ekaggrat/eptaora/stl/main drive gear.stl

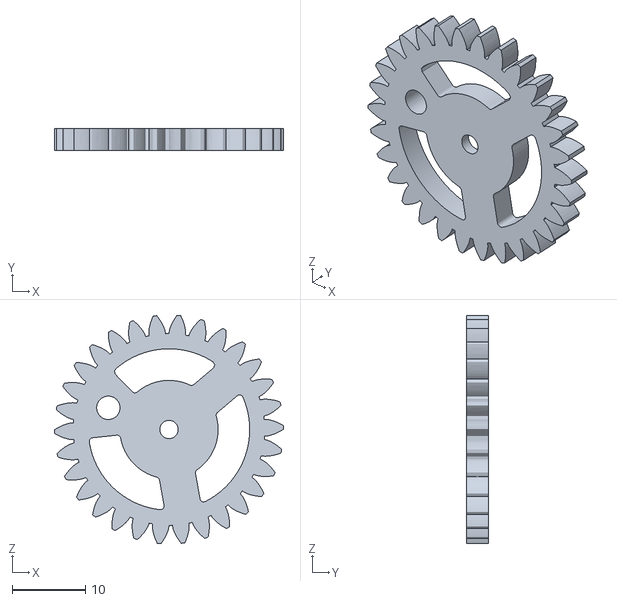
[picture p1: CAD file, 2022-10-17]
stl/main drive gear.stl
31.3 x 3.00 x 31.2
