ekaggrat/eptaora/stl/pinion pin.stl

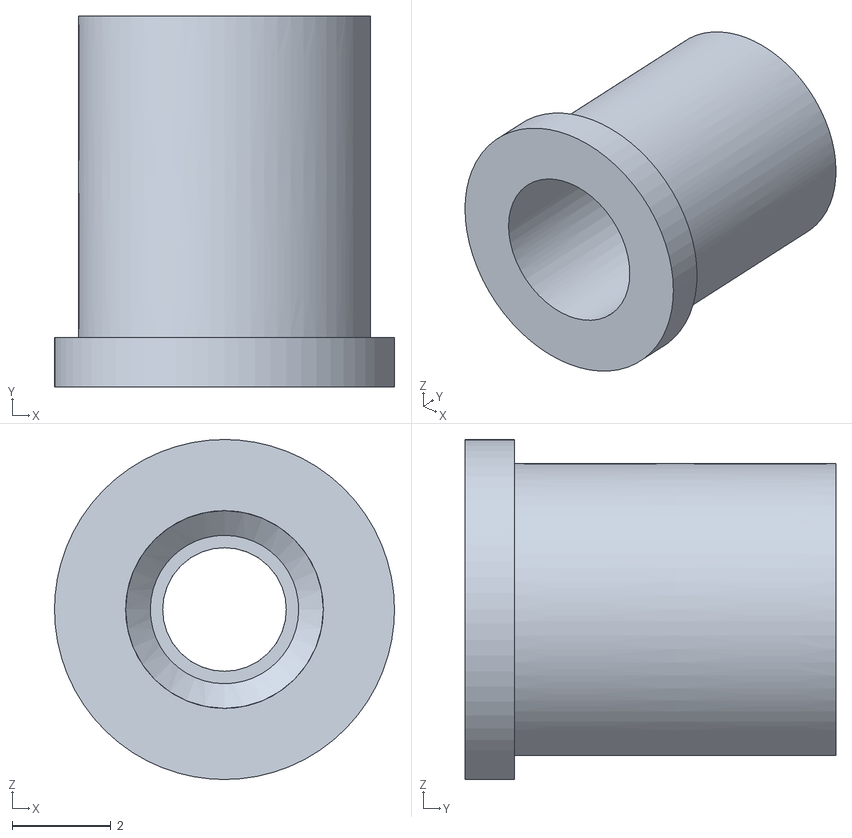
[picture p2: CAD file, 2022-11-07]
stl/pinion pin.stl
6.88 x 7.50 x 6.88
