ekaggrat/eptaora/stl/idler gear.stl

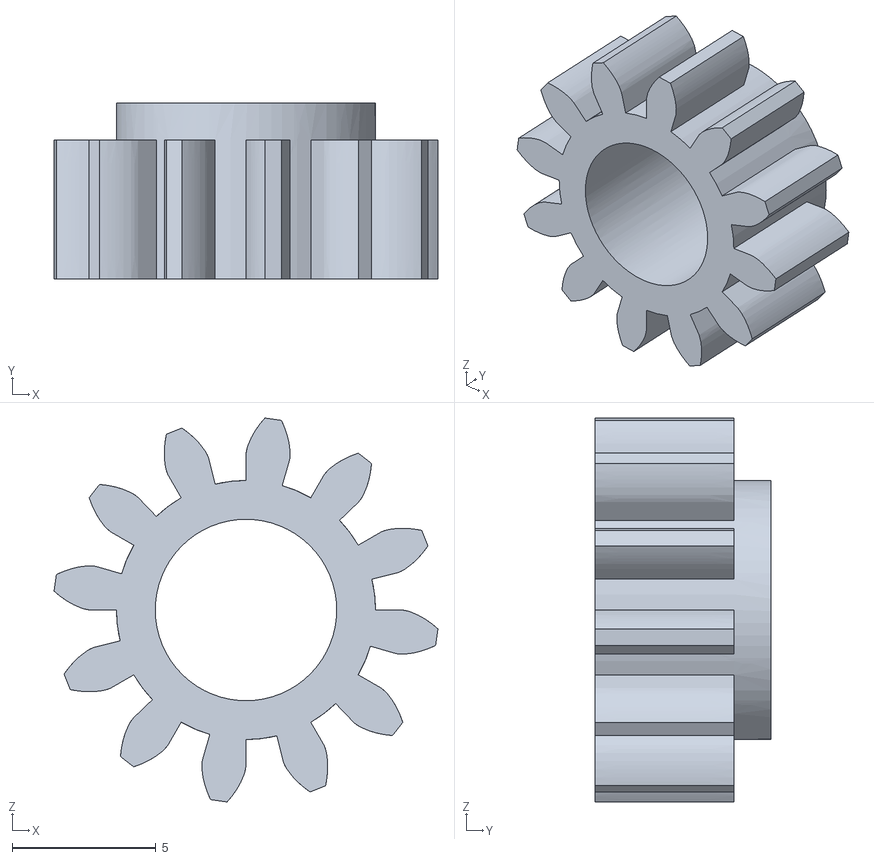
[picture p3: CAD file, 2022-10-17]
stl/idler gear.stl
13.3 x 6.10 x 13.3
