ekaggrat/eptaora/stl/follower.stl

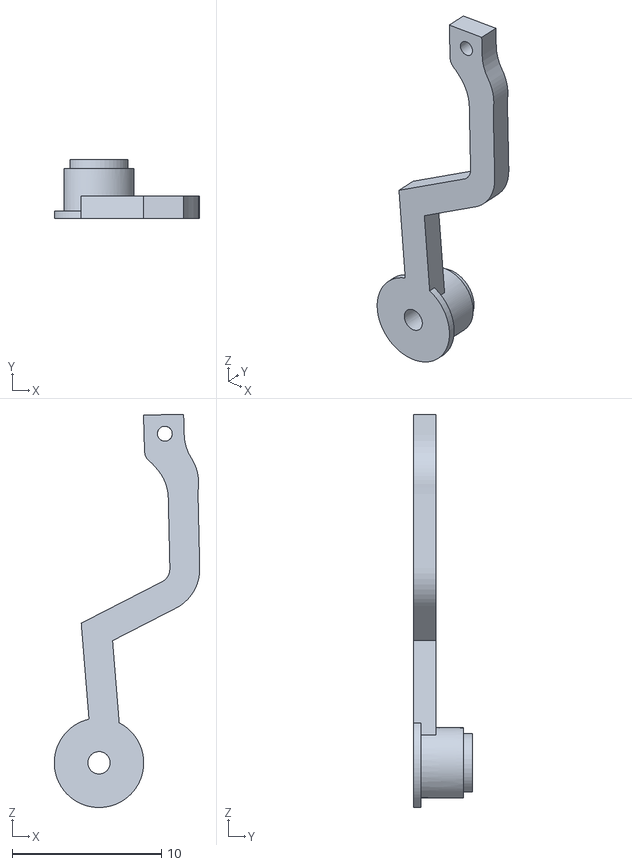
[picture p4: CAD file, 2022-10-17]
stl/follower.stl
9.74 x 3.95 x 26.3
