ekaggrat/eptaora/stl/back connector no motor.stl

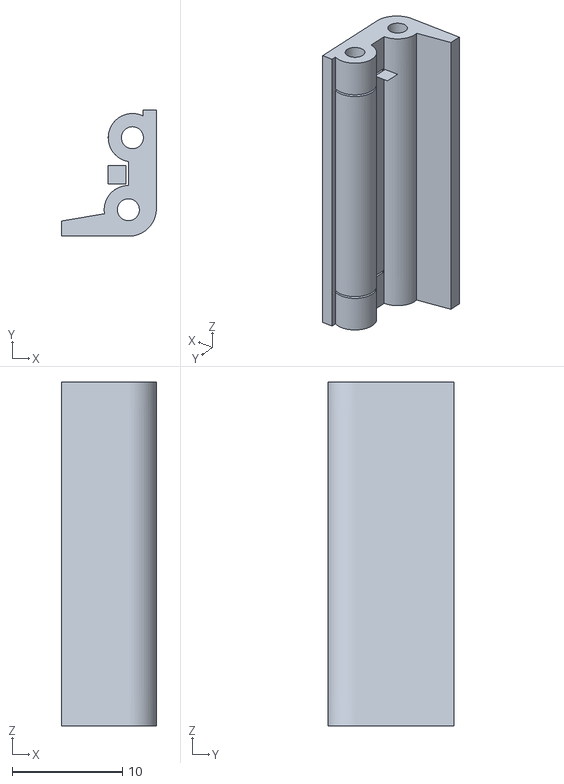
[picture p5: CAD file, 2022-10-17]
stl/back connector no motor.stl
8.61 x 11.5 x 31.3
