ekaggrat/eptaora/stl/rod bending jig.stl

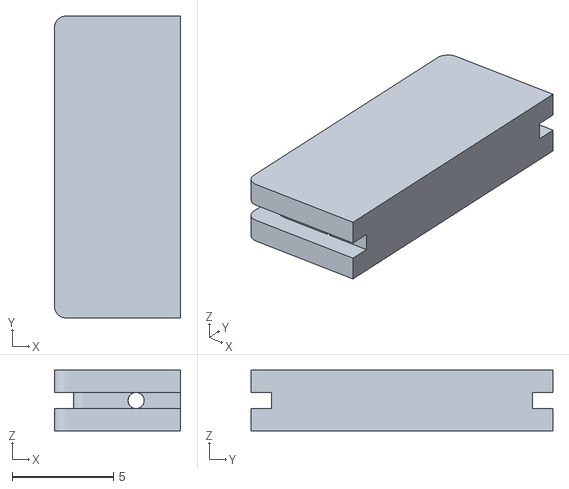
[picture p6: CAD file, 2022-10-17]
stl/rod bending jig.stl
6.24 x 14.9 x 3.00
