ekaggrat/eptaora/stl/motor back.stl

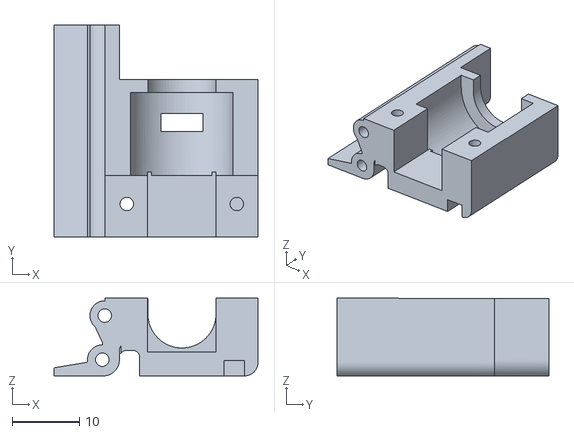
[picture p7: CAD file, 2022-10-17]
stl/motor back.stl
30.3 x 31.5 x 11.6
