ekaggrat/eptaora/stl/drum spacer.stl

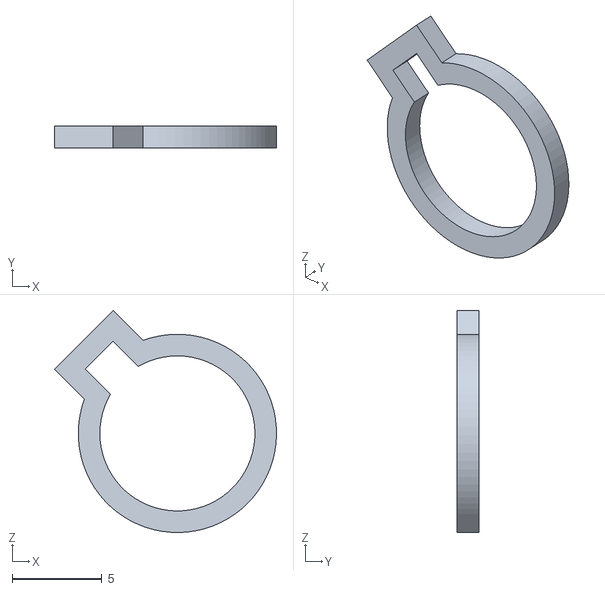
[picture p8: CAD file, 2022-10-17]
stl/drum spacer.stl
12.3 x 1.20 x 12.3
