ekaggrat/eptaora/stl/cams.stl

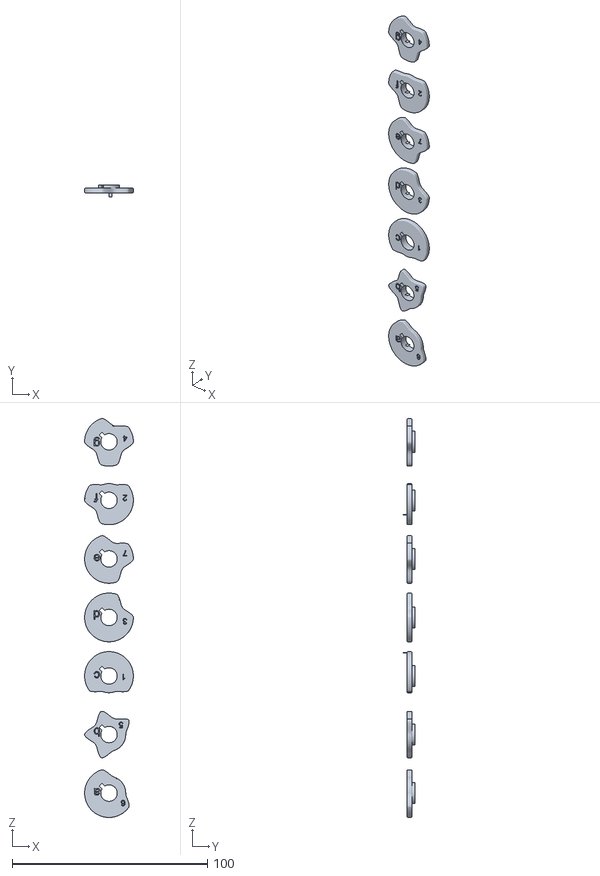
[picture p9: CAD file, 2022-10-17]
stl/cams.stl
25.0 x 6.00 x 204.4
