ekaggrat/eptaora/stl/digit caps.stl

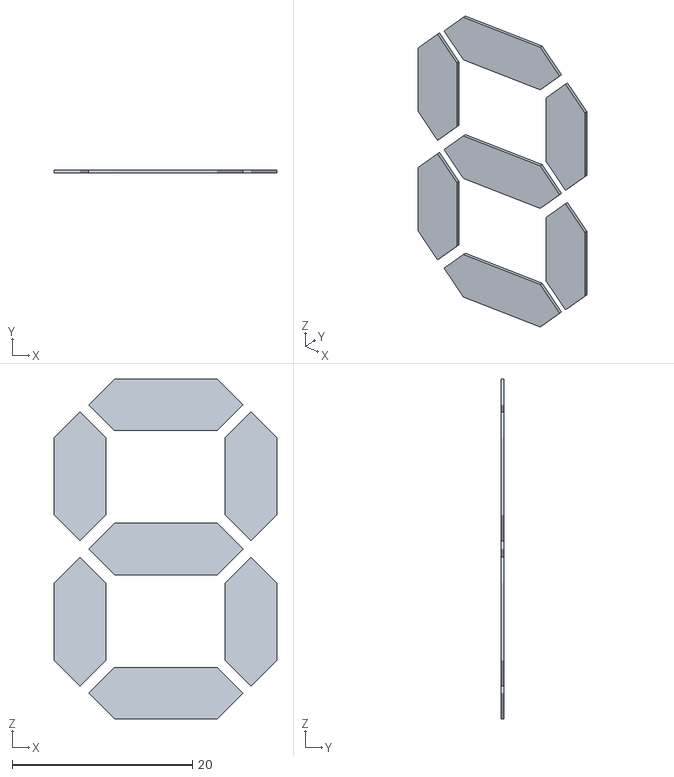
[picture p10: CAD file, 2022-10-17]
stl/digit caps.stl
24.7 x 0.383 x 37.8
