ekaggrat/eptaora/stl/motor cap.stl

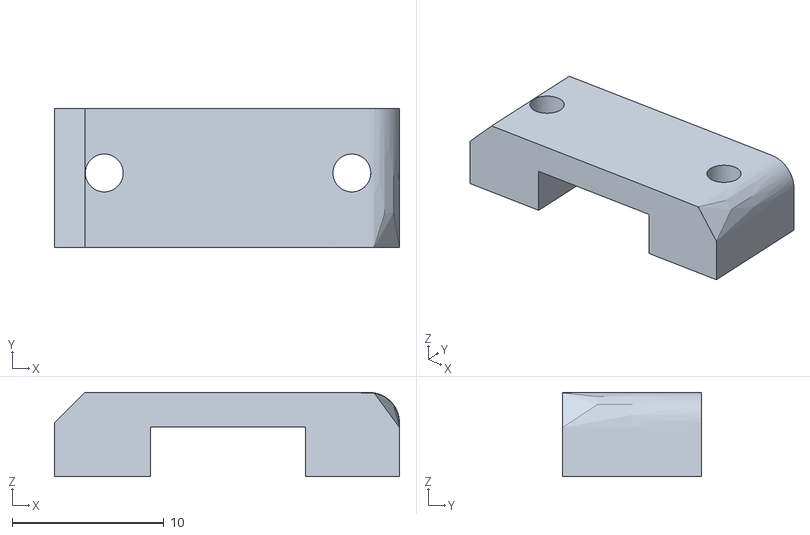
[picture p11: CAD file, 2022-10-17]
stl/motor cap.stl
22.7 x 9.17 x 5.55
