ekaggrat/eptaora/stl/follower cap.stl

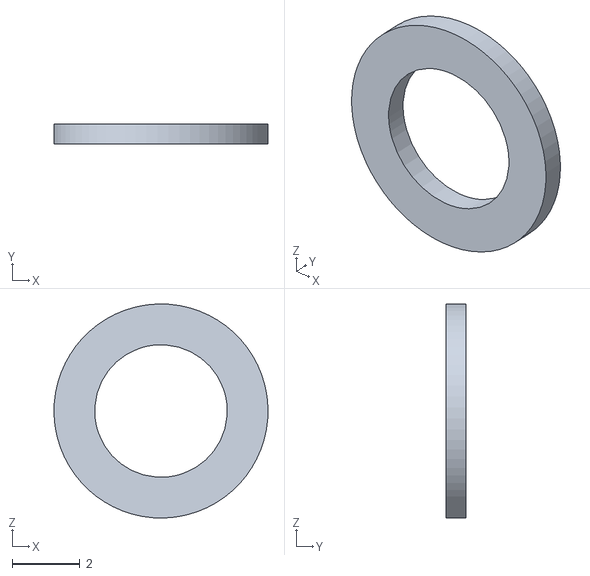
[picture p12: CAD file, 2022-10-17]
stl/follower cap.stl
6.30 x 0.6 x 6.30
