ekaggrat/eptaora/stl/motor gear.stl

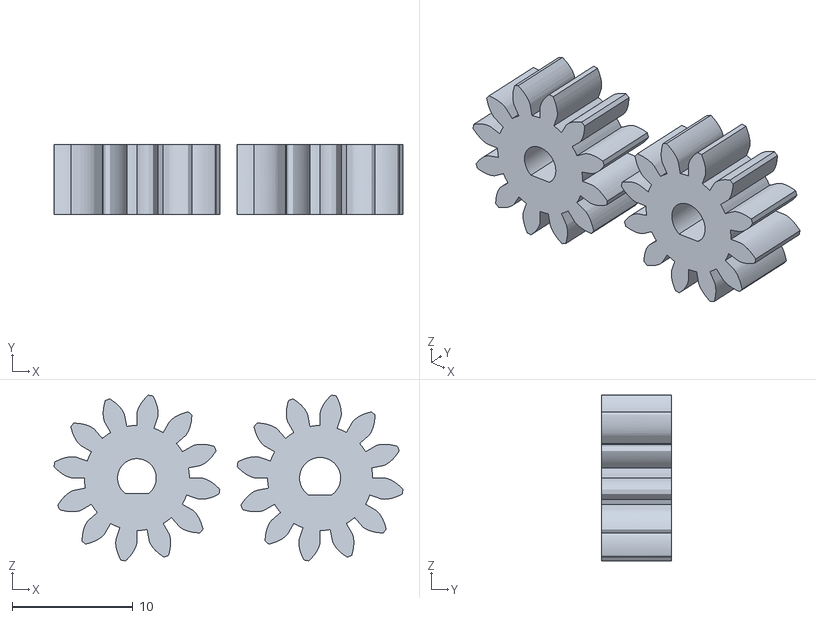
[picture p13: CAD file, 2022-10-17]
stl/motor gear.stl
28.9 x 5.80 x 13.7
