ekaggrat/eptaora/stl/center drum.stl

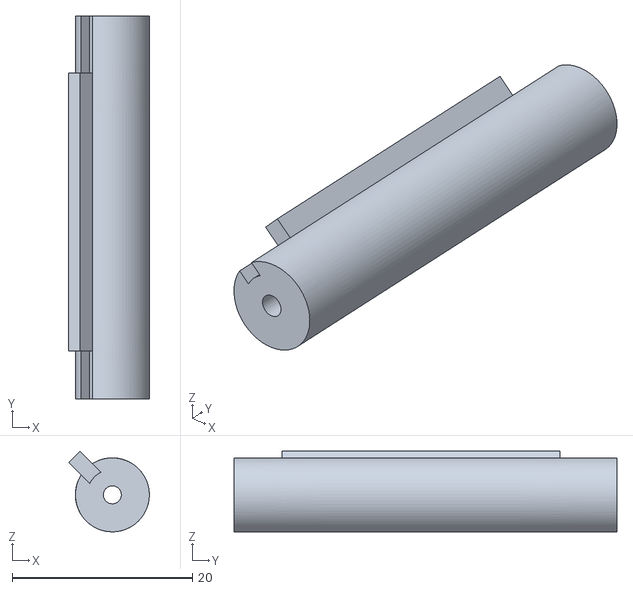
[picture p14: CAD file, 2022-10-17]
stl/center drum.stl
8.96 x 42.5 x 8.96
