ekaggrat/eptaora/stl/right frame.stl

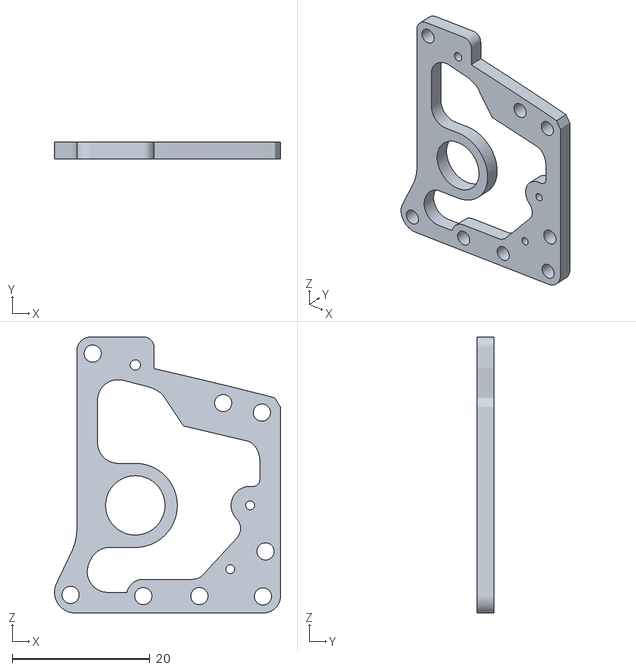
[picture p15: CAD file, 2022-10-17]
stl/right frame.stl
32.8 x 2.50 x 40.1
