ekaggrat/eptaora/stl/follower spacer.stl

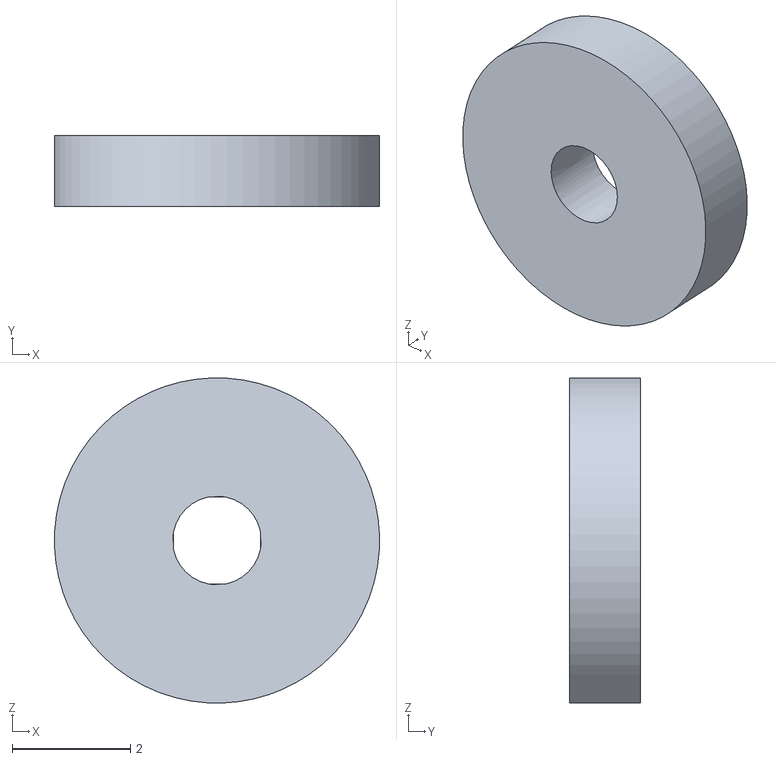
[picture p16: CAD file, 2022-10-17]
stl/follower spacer.stl
5.50 x 1.20 x 5.50
