ekaggrat/eptaora/stl/digits.stl

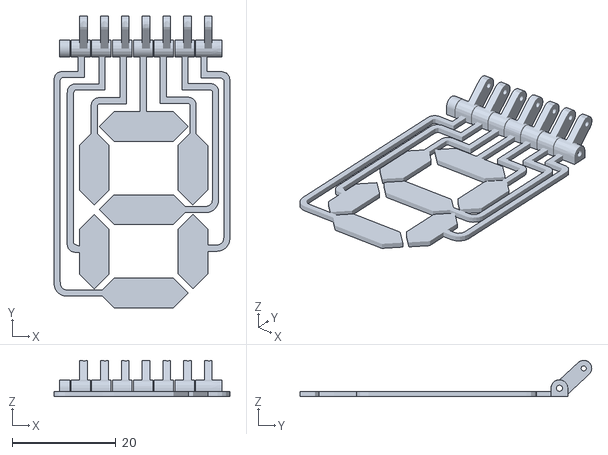
[picture p17: CAD file, 2022-10-17]
stl/digits.stl
33.9 x 56.1 x 7.01
