ekaggrat/eptaora/stl/left frame.stl

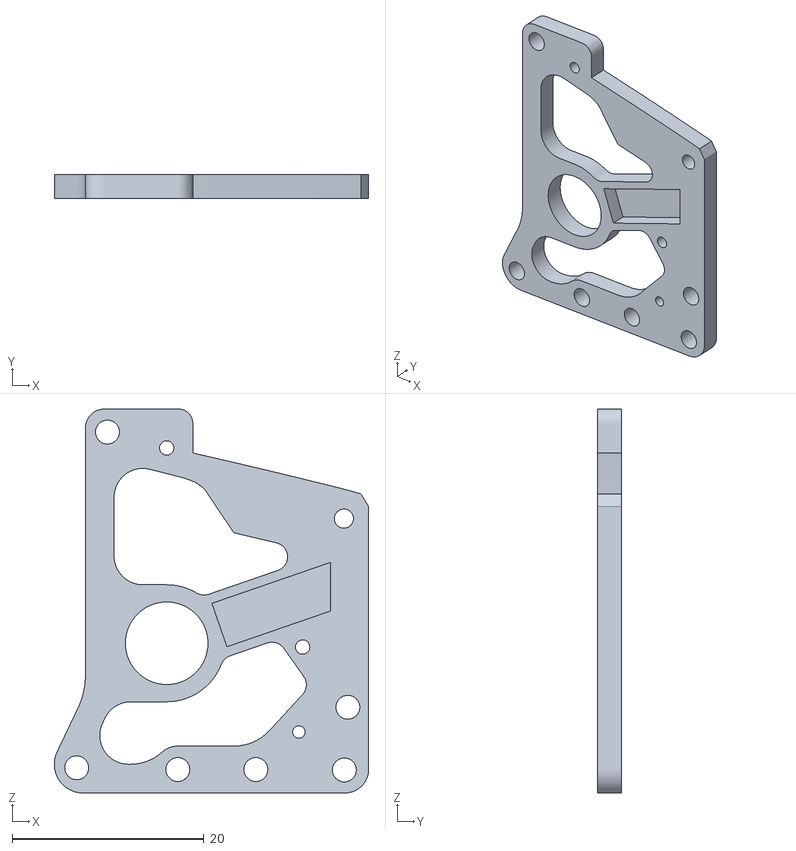
[picture p18: CAD file, 2022-10-17]
stl/left frame.stl
32.8 x 2.50 x 40.1
