ekaggrat/eptaora/stl/bottom connector.stl

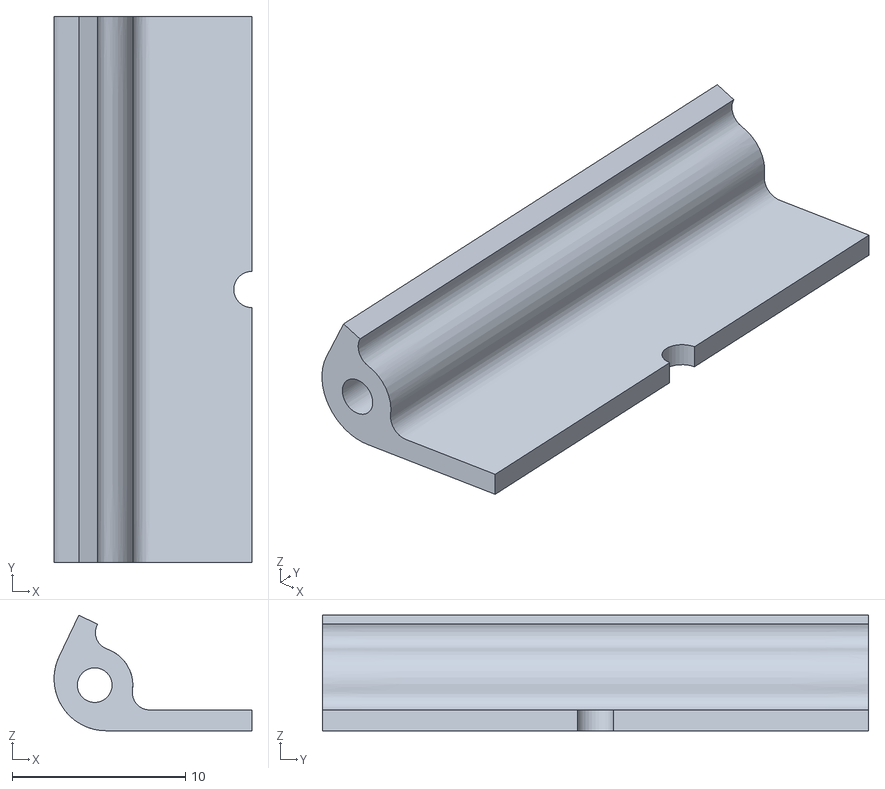
[picture p19: CAD file, 2022-10-17]
stl/bottom connector.stl
11.4 x 31.5 x 6.67
