ekaggrat/eptaora/stl/top connector.stl

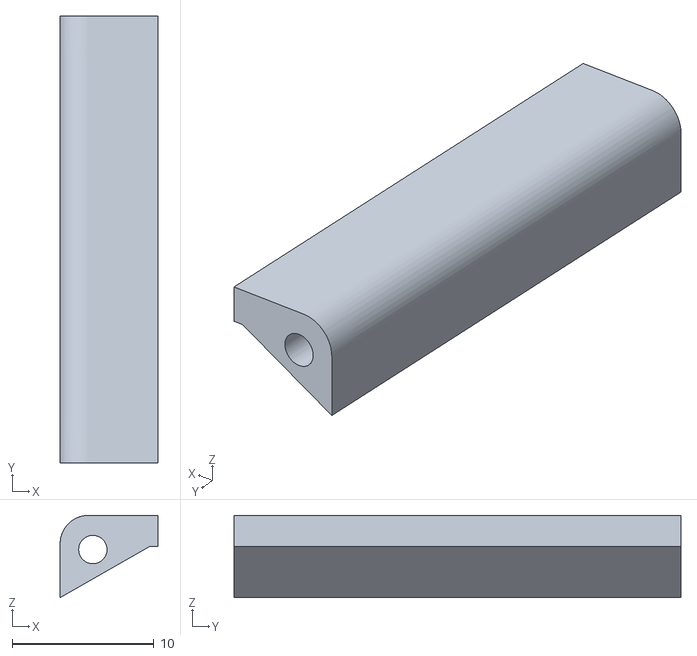
[picture p20: CAD file, 2022-10-17]
stl/top connector.stl
6.90 x 31.5 x 5.80
