ekaggrat/eptaora/(threads)

Thread 2 (2022-11-01):

Idler gear spindle

psjshep, 2022-11-01:
Great project - I've got all the parts printed... but don't see how the idler gear is mounted - is there a spindle missing?

Phil

psjshep, 2022-11-01:
also, what connects to the drum on the opposite end to the main drive gear?

ekaggrat, 2022-11-07:
sorry . i updated it

Closed 2022-11-07.

Thread 3 (2022-11-07):

2 more pieces missing from centre drum

psjshep, 2022-11-07:
Thx for including the pinion pin stl....

There are 2 other pieces missing from the end of the centre drum... in diagram https://cdn.hackaday.io/images/6511831665221138021.jpg

The disk & the gear on the far left hand side, both labelled with the letter "A"

Phil

ekaggrat, 2022-11-08:
those are optional to connect the next module. I will release them later

psjshep, 2022-11-08:
ok... thx

Closed 2023-12-20.

Thread 4 (2022-11-07):

Wire diameters

carr-james, 2022-11-07:
Really appreciate this open source project you've put together, it looks very cool and I'd love to build one myself! I am confused by the instructions as there are some places where it mentions 0.2mm diameter spring wire and some places that call for 0.4mm, which is it?

ekaggrat, 2022-11-07:
it is 0.4 for the hooks and 0.2-0.3 foe the springs .a little variation wont matter.

carr-james, 2022-11-07:
Ah brilliant, I ordered both just in case. Glad to know they will both be used! Maybe a bill of materials would be useful for others, as it can be difficult to figure out what's needed

Closed 2023-12-20.

Thread 7 (2023-05-30):

Is this project abandoned?

Jozer99, 2023-05-30:
I really like this clock design and I would love to build one, but you haven't released the full set of files.  Is this design ever going to be open sourced or at least made into a purchasable kit?  I realize someone stole the design on kickstarter, but I would much prefer to pay the original designer.

PlanorPlay, 2023-08-27:
It look like is

ekaggrat, 2023-08-28:
it is not, t is just very difficult to assemble it and so i didnt release all the files.  It was released by someone else as a kickstarter  ( yet to be delivered ) so I lost motivation to put it out as a instructable or all the files as I would have a flood of queries about assembly in my mailbox!

ZjcNB, 2023-09-24:
It is indeed a bit difficult to assemble, can it be improved?

ZjcNB, 2023-09-24:
Can you post your latest model files?

Jozer99, 2023-12-20:
You marked as completed, but you haven't uploaded new files in several years.  The files on the website are not complete.  Please re-open this ticket.

ekaggrat, 2023-12-20:
I will eventually make it a kit but I stopped as there is the **rantoge project** which is a big scam. So I don't want to publish till I was a sellable kit with documentation and that's why I am not giving away all the cad files for free

Thread 8 (2023-08-26):

CAD files

1JonaB1, 2023-08-26:
Hello, your project seems great.
I would like to modify the clock to work with different motors and machine some parts for the Clock out of aluminum. For this the CAD files would be extremely helpful

Jona

jschoch, 2023-12-17:
https://fablabsendai-flat.com/2019/11/04/mechanical7seg_en/

ekaggrat, 2023-12-20:
yes it is not original and is inspired from that project. so you can very well make your own derivative. I never claimed to invent it . I jus optimized it to be smaller and 3d printable

Closed 2023-12-20.
