ekaggrat/eptaora/(commit log)

2022-10-17 this is the repository to the eptaora project .
    more details at : https://hackaday.io/project/187684-eptaora
    [back connector no motor.stl, bottom connector.stl, cams.stl, center drum.stl, digit caps.stl, digits.stl, drum spacer.stl, follower cap.stl]
2022-10-17 Create dual_motor_attiny84 .ino
    arduino code
2022-11-07 Create pinion pin.stl
    [pinion pin.stl]
